atestokhay/autonomous-car/software/notes/README.md

# notes — Yardımcı notlar

| Dosya | Ne zaman bak |
|---|---|
| `kurulum-ubuntu-ros.md` | Pi'ye Ubuntu 24.04, ROS 2 Jazzy, LiDAR sürücüsü kurarken |
| `sorun-giderme.md` | Bir şey çalışmıyorsa: **belirti → kontrol edilecek yer** tablosu (aşama aşama) |
| `kavramlar.md` | PID, enkoder, odometri, SLAM kelimeleri anlamadığında |

**Acil durum ve "hiçbir şey çalışmıyor" için sıralı liste:** `arac acil`. Önce `python3 tools/diag.py` çalıştır (motor oynatmaz), `diag_rapor.txt`'yi gönder.

**Altın kural:** sorunu bulamazsan ekrandaki çıktıyı (komut + hata satırları) olduğu gibi kopyala,
hangi aşamada olduğunu yaz, öğretmene gönder. "Çalışmıyor" yerine çıktıyı göndermek sorunu çok hızlı çözer.
