atestokhay/autonomous-car/software/stages/07-duvar-takibi/ornek_blok.png

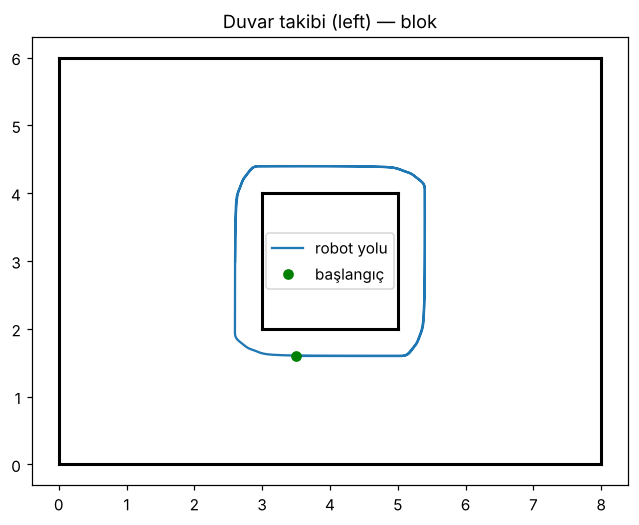
software/stages/07-duvar-takibi/ornek_blok.png
