atestokhay/autonomous-car/software/stages/07-duvar-takibi/ornek_oda.png

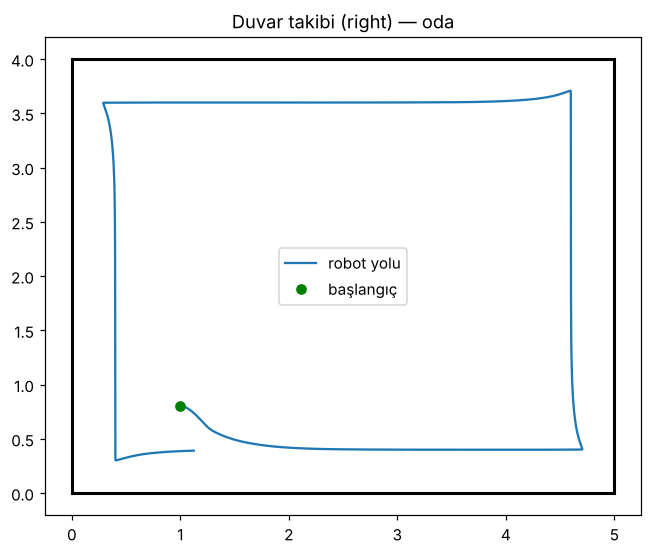
software/stages/07-duvar-takibi/ornek_oda.png
