atestokhay/autonomous-car/(list of files, drawings)

Other design files:
hardware/wiring/schematic.fzz
