atestokhay/autonomous-car/(commit log)

2026-10-27 feat: otonom arac tum proje yapisi ve kablolama semalari
    [schematic.fzz]
2026-10-29 Add software: PID autotune, odometry, LiDAR wall following, ROS 2 nodes, stage READMEs, notes
    Claude-Session: https://claude.ai/code/session_017nBBJt4SzMEYBet2QC73pe
    [pid.yaml, robot.yaml]
2026-10-29 Review pass: acil durum rehberi, test sayfası, teşhis aracı, donanım kararları, LiDAR başlatma düzeltmesi
    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
2026-10-29 Add one-command installer kurulum.sh and wire it into the student guide
    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
2026-10-29 Restore repository to its original state (hardware only); software moved to autonomous-car-v2
    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
    [pid.yaml, robot.yaml]
2026-10-29 Add software v1.0 (student wizard calistir.py, PID autotune, wall following, ROS nodes, notes)
    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
    [pid.yaml, robot.yaml]
2026-10-29 Wizard: add wiring guide (kablolama), arac kablo/acil subcommands, docs/acil-durum.md
    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
2026-10-29 Fix: --mock progress stored separately; friendly error when gpiodetect missing
    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
    [gpio_backend.py, ortak.py]
